GabrielAntonioVillegas/Auto-a-Control-Remoto/README.md

# Auto a control remoto con Arduino
#### Proyecto realizado en el año 2023
#### Formato: Trabajo en Equipo
#### Equipo conformado por 3 integrantes
#### ¡Este auto fue una maravilla! Aqui te dejo sus caracteristicas: 
- Manejado desde el celular por una aplicacion que se conectaba al auto por Bluetooth
- Todo el auto era controlado por una placa Arduino UNO
- Contaba con una bocina y un controlador de audio al que tambien se conectaba por Bluetooth y podia usarse para reproducir musica 
- Contaba con 4 motores
- Sistema de Luces delanteras y traseras
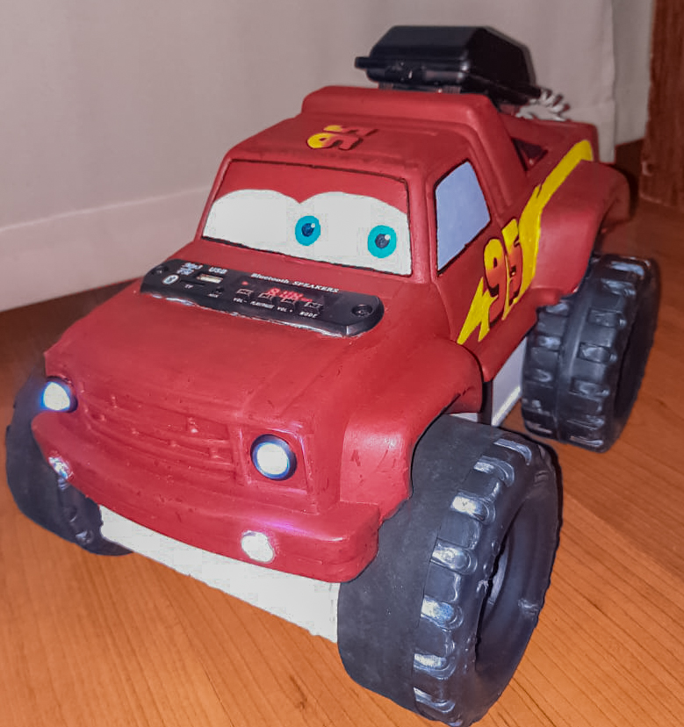
[picture p1: foto.jpg]
autito
